nancyzhe/BUSeniorDesign-Opticle/examples/README.md

# Examples

In this directory there are usage examples of DepthAI Python library.

In the [test folder](https://github.com/amg1998/BUSeniorDesign-ViSiO-21-22/tree/main/examples/test) is a file that can be used to test the OAK-D camera.

## Description

More details about examples can be found at [Luxonis DepthAI API - Code Samples](https://docs.luxonis.com/projects/api/en/latest/tutorials/code_samples/)

## Setup

```
python3 install_requirements.py
OR
python install_requirements.py (Windows)

```
