nancyzhe/BUSeniorDesign-Opticle/CAD files/WristMount.step

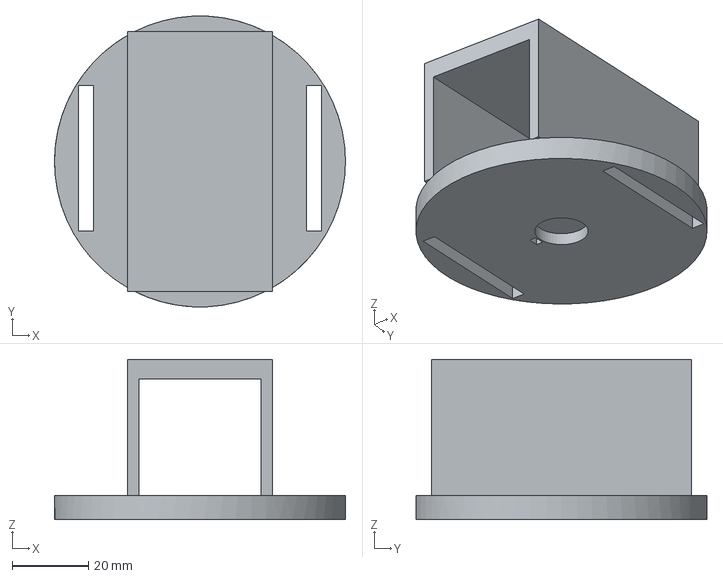
[picture p13: CAD file, 2022-04-28]
CAD files/WristMount.step
76.2 x 76.2 x 41.9 mm
