nancyzhe/BUSeniorDesign-Opticle/CAD files/piholder.step

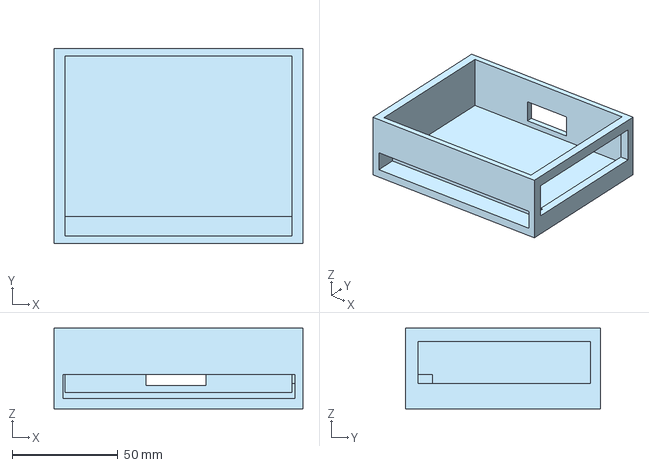
[picture p14: CAD file, 2022-04-28]
CAD files/piholder.step
117.5 x 91.9 x 38.1 mm
