nancyzhe/BUSeniorDesign-Opticle/CAD files/powerbankholder.step

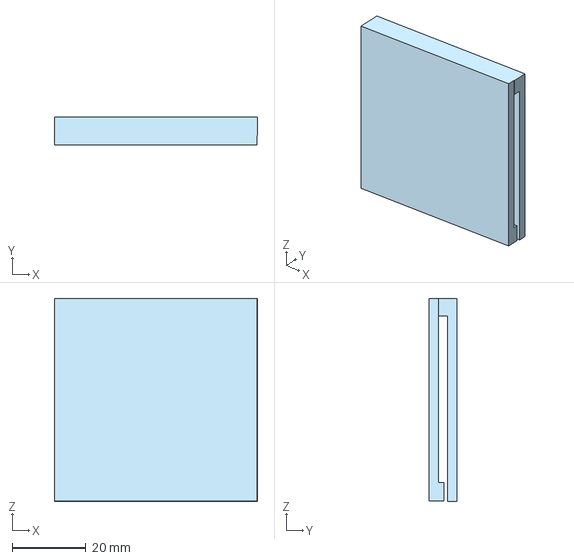
[picture p15: CAD file, 2022-04-28]
CAD files/powerbankholder.step
55.0 x 7.50 x 55.0 mm
