nancyzhe/BUSeniorDesign-Opticle/CAD files/OAK-D mount.step

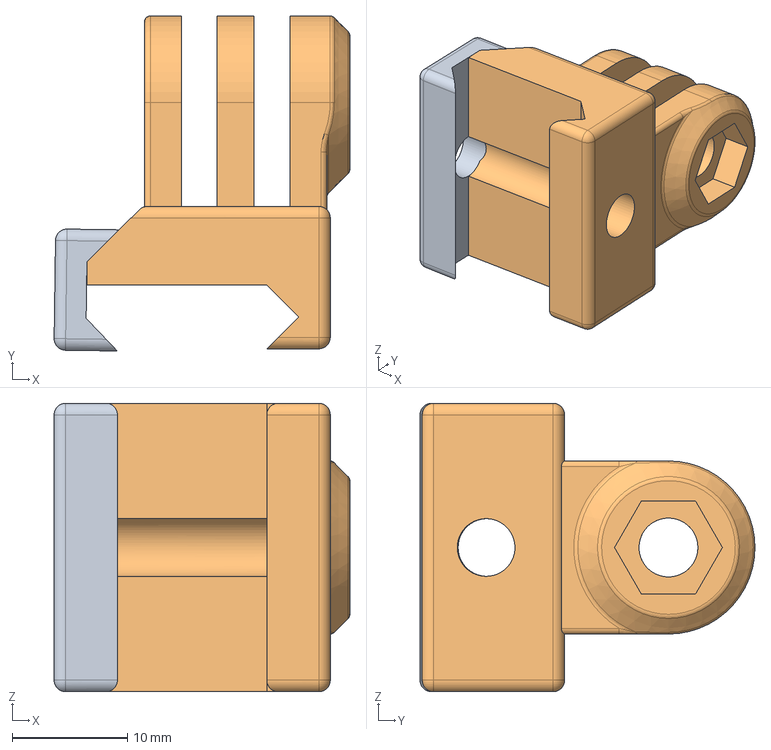
[picture p16: CAD file, 2022-04-28]
CAD files/OAK-D mount.step
25.6 x 29.0 x 25.0 mm
Parte B
Parte A
