nancyzhe/BUSeniorDesign-Opticle/(list of files, cad)

Other CAD files:
CAD files/Wrist Mount.step
