nancyzhe/BUSeniorDesign-Opticle/(commit log)

2021-11-02 motor works
2021-11-09 added motor functionality to yolo code
2022-03-28 Luca pointcloud (#2)
    * added xyz visualization points
    * Update main.py
    * drew bounding box
    * created bounding box and counted points
    * adding intrinsic matrix
    * fixed dependency issue
    * changed x coordinate by 0.5
    * box is at border of the data, need to reduce size
    * fixed bounding box
    * added motors
    * added client code to main
    * fixed for new depthai version
    * works on laptop
    * fixed box
    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
    [main.py, spatial_tiny_yolo.py]
2022-03-29 Luca pointcloud (#3)
    * combined files
    * handle model
    * navigation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
    [spatial_tiny_yolo.py]
2022-03-31 Ag speech (#4)
    * speechrec
    * added speech and switch
    * testing
2022-04-27 Cleaned (#5)
    * checkpoint
    * checkpoint
    * feedback checkpoint
    * new sound
    * audio works
    * fixed RPi setup
    * removed files
    * added reqs
    [spatial_tiny_yolo.py]
